jakelicata/SunTracker/Mechanical Description.pdf

## ESC Sun Tracker with One Actuator Motion Manual

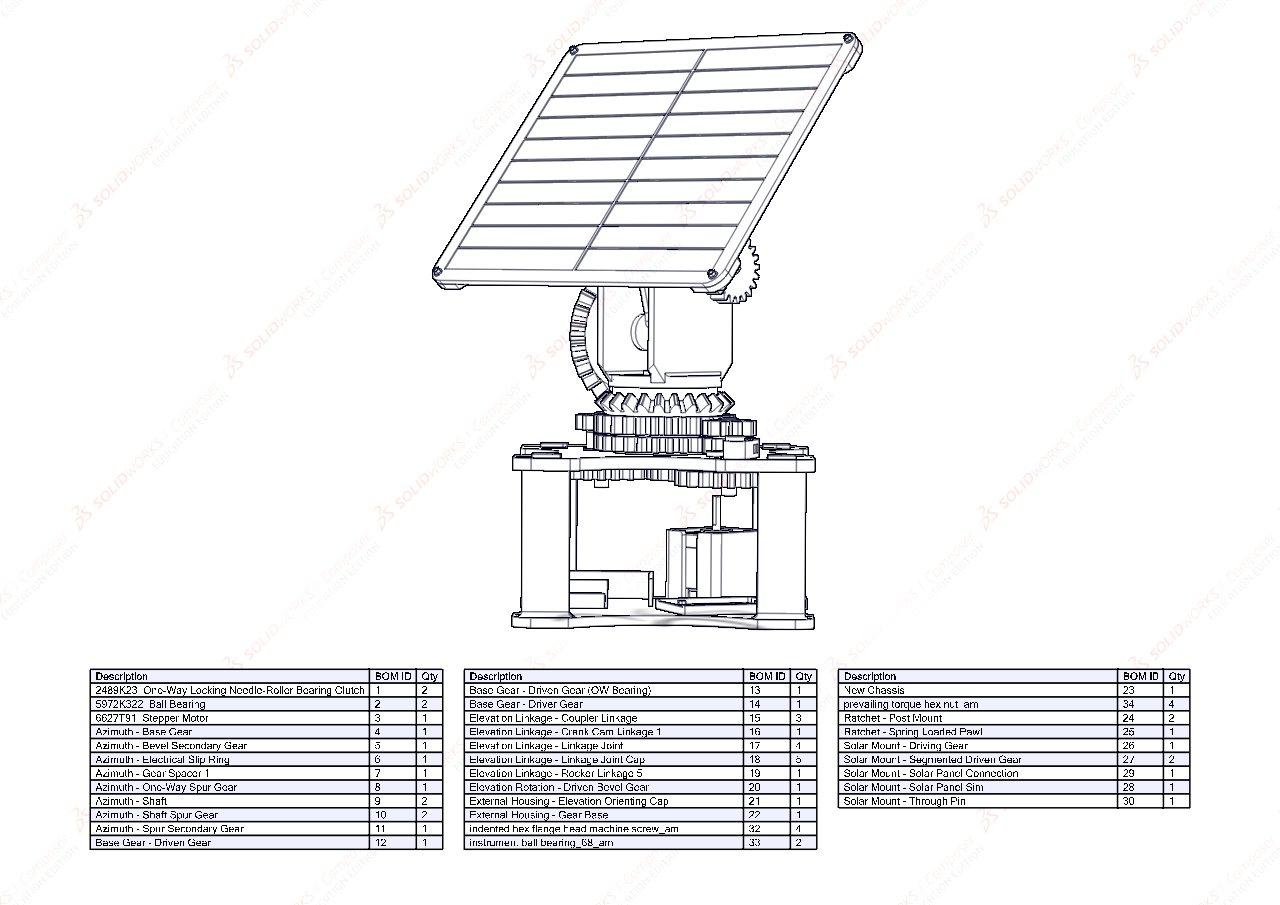
[picture p1: figure]

## PSU LF Capstone

Matthew Kuzmich | David Gogiberidze
Logan Ellenberger | Saje Behari
Jake Licata | Jeffery Su
Michael Day

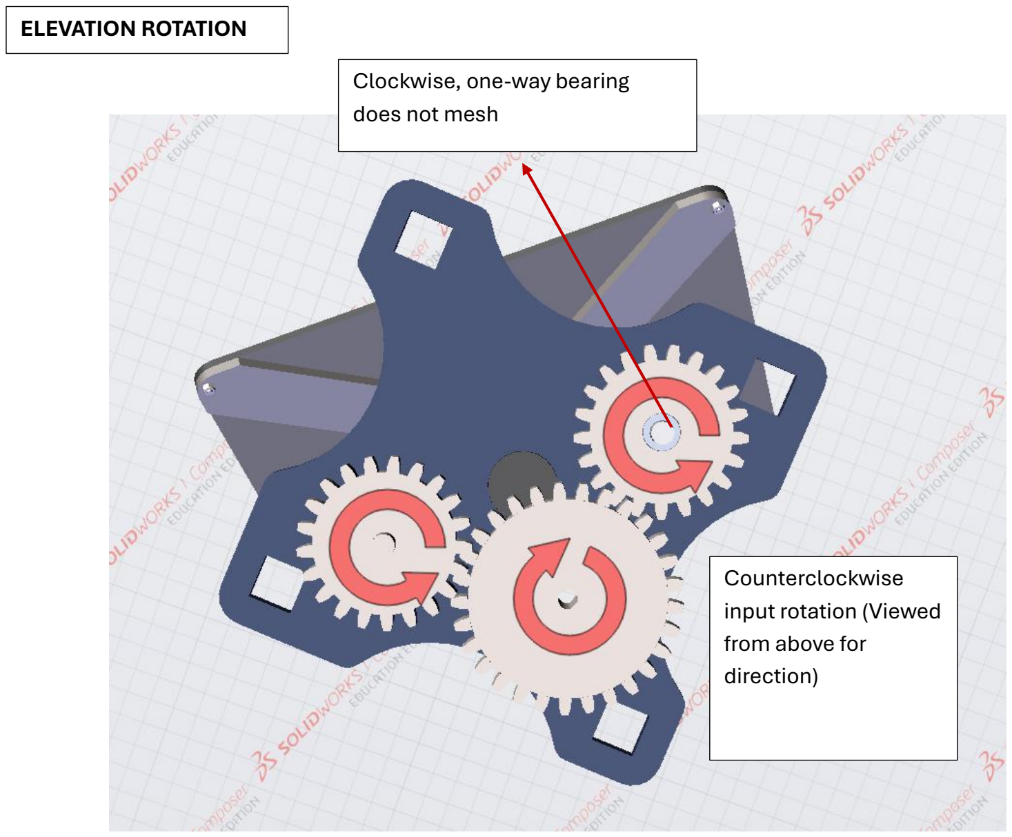
[picture p2: page 2]

Counterclockwise
input rotation (Viewed
from above for
direction)

Clockwise, one-way bearing does not mesh

ELEVATION ROTATION

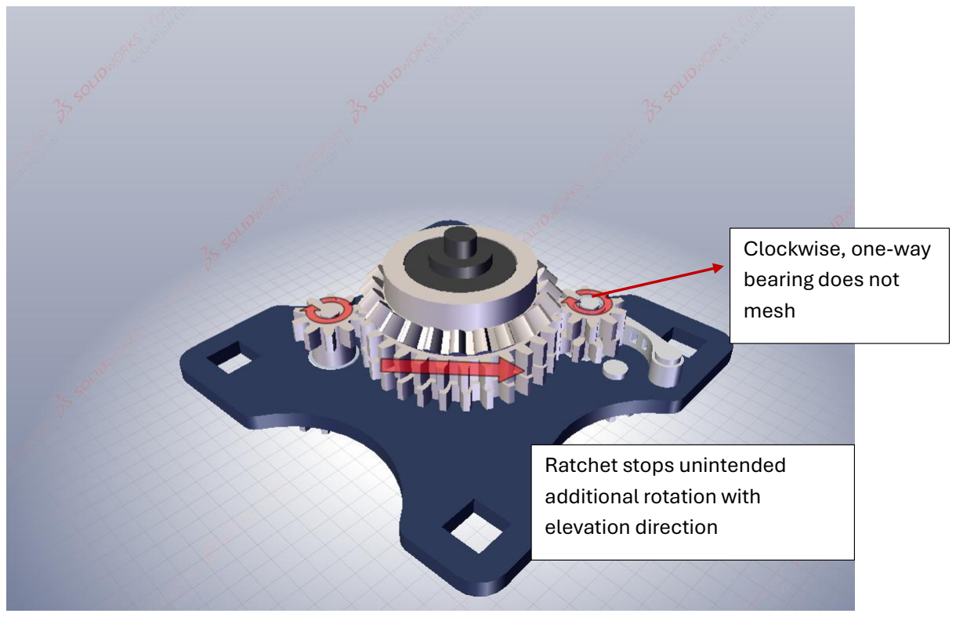
[picture p3: page 3]

Clockwise, one-way
bearing does not
mesh

Ratchet stops unintended
additional rotation with
elevation direction

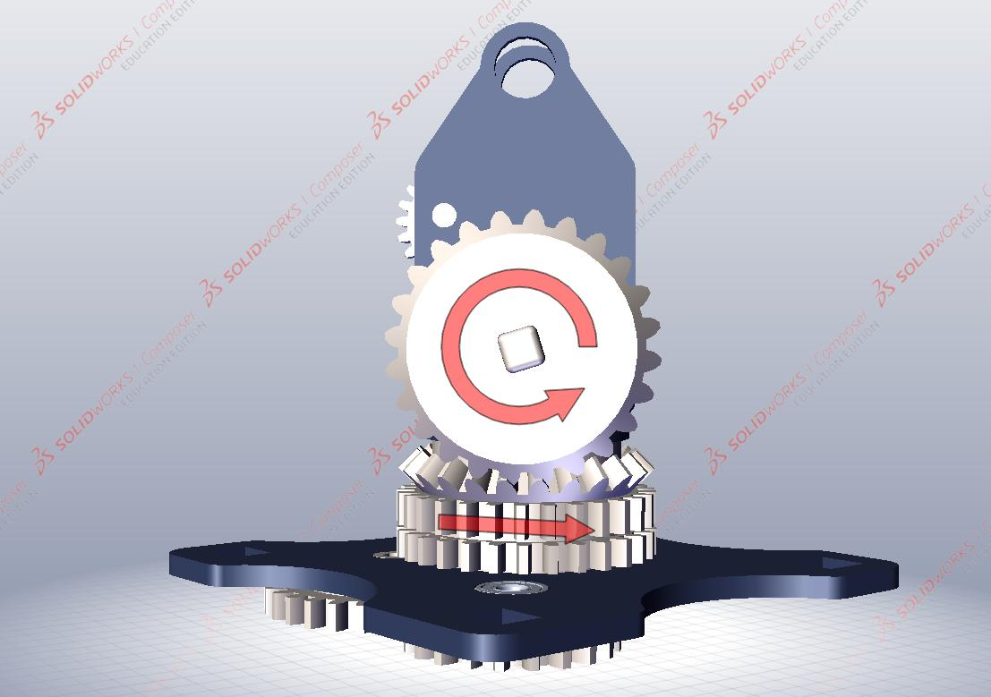
[picture p4: figure]
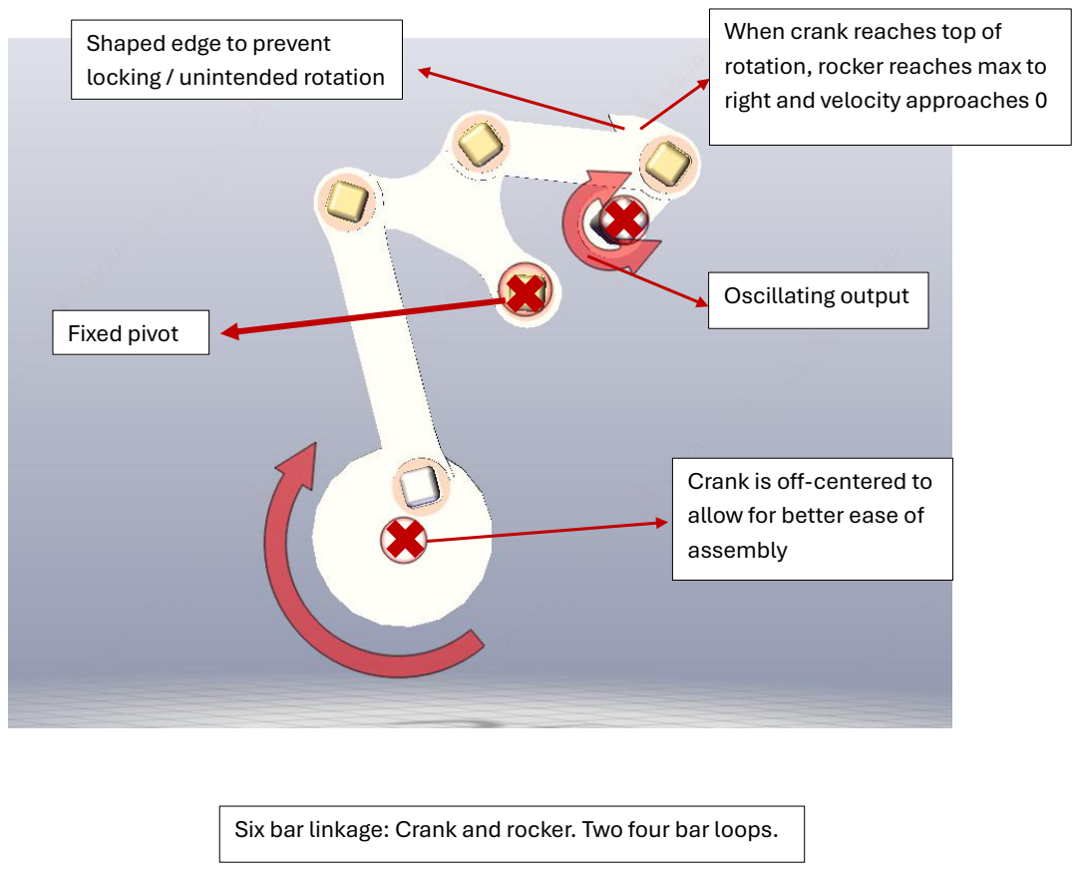
[picture p5: page 5]

Six bar linkage: Crank and rocker. Two four bar loops.

Crank is off-centered to
allow for better ease of
assembly

When crank reaches top of
rotation, rocker reaches max to right and velocity approaches 0

Shaped edge to prevent
locking / unintended rotation

Oscillating output
Fixed pivot

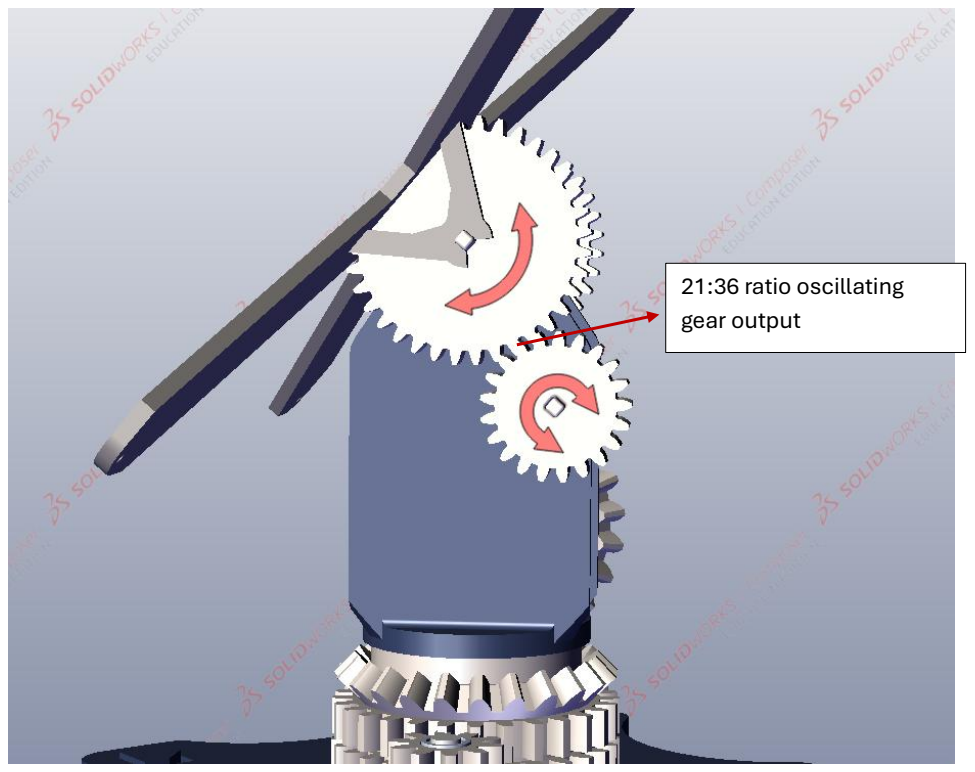
[picture p6: page 6]

21:36 ratio oscillating
gear output

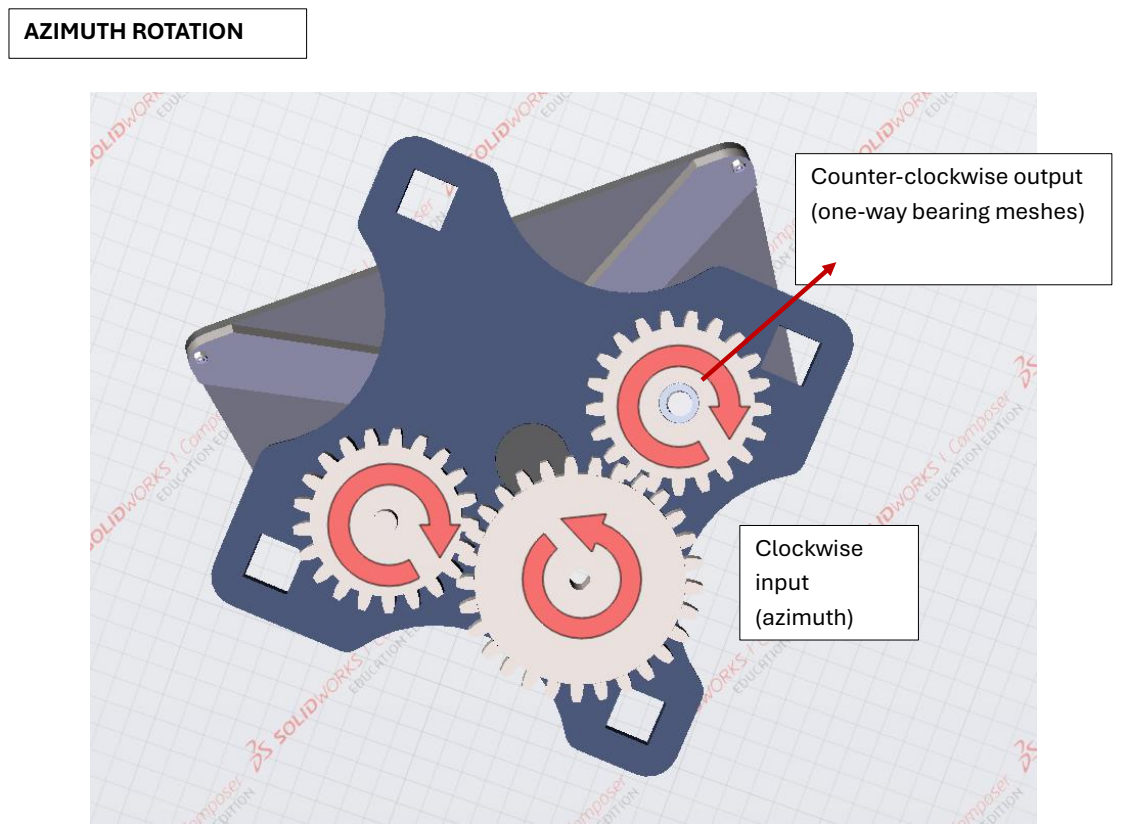
[picture p7: page 7]

Clockwise
input
(azimuth)

Counter-clockwise output
(one-way bearing meshes)

AZIMUTH ROTATION

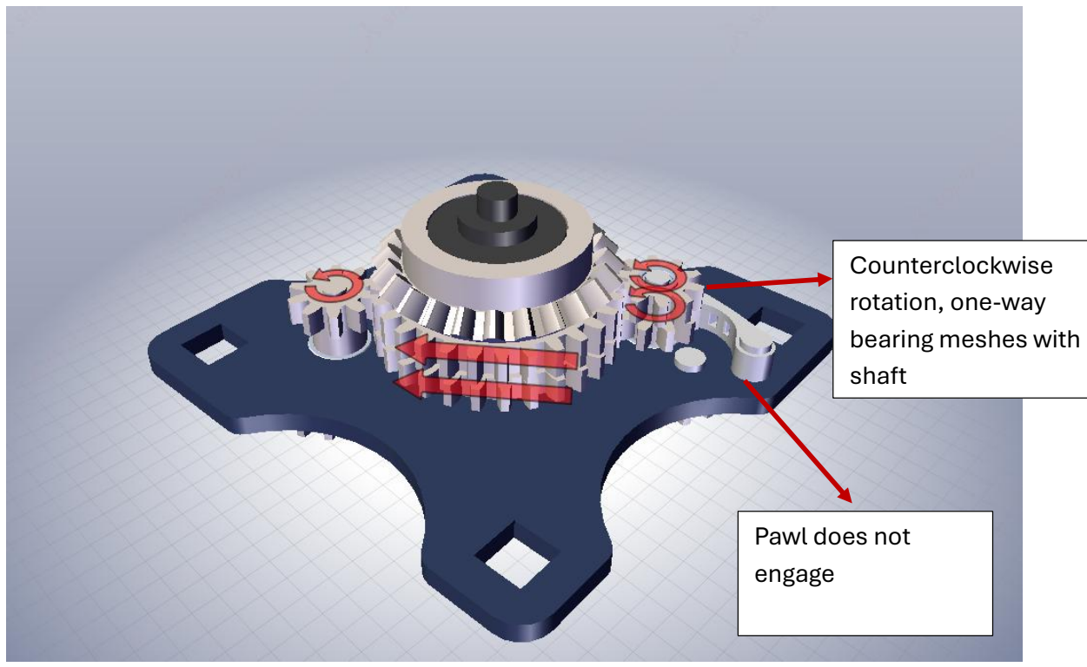
[picture p8: figure]
Counterclockwise rotation, one-way bearing meshes with shaft; Pawl does not engage
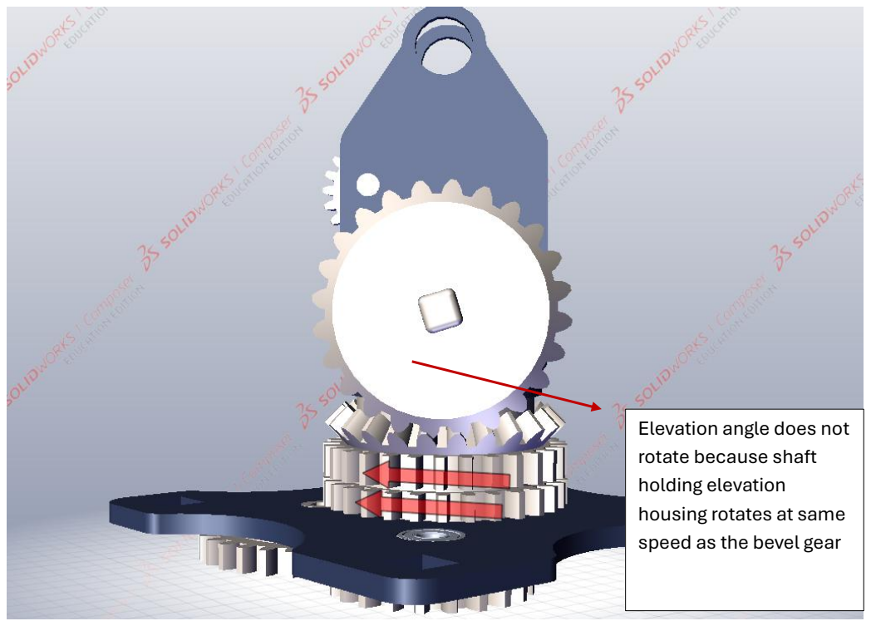
[picture p9: page 9]

Elevation angle does not
rotate because shaft
holding elevation
housing rotates at same
speed as the bevel gear

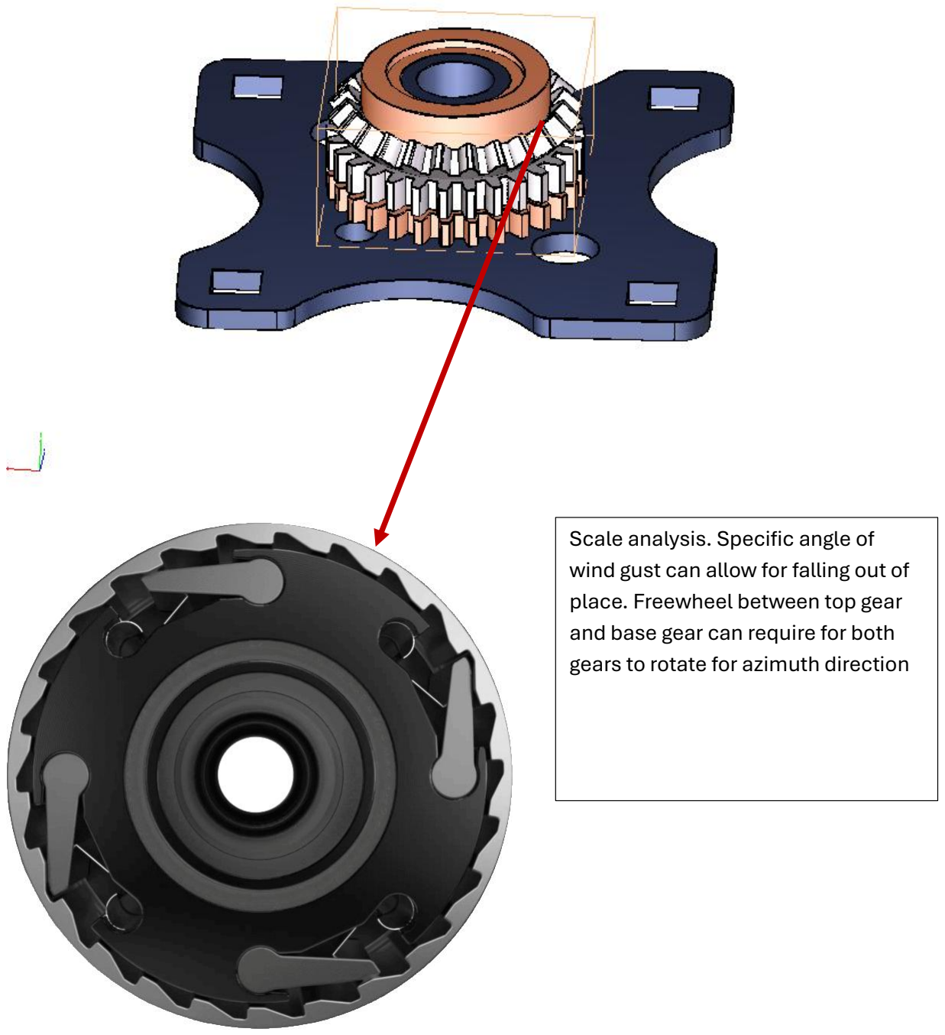
[picture p10: page 10]

Scale analysis. Specific angle of wind gust can allow for falling out of place. Freewheel between top gear and base gear can require for both gears to rotate for azimuth direction
