jakelicata/SunTracker/(commit log)

2025-03-31 Create Motor movement
2025-04-16 Rename davidIMUcode to david original IMU code
2025-04-16 Rename rtc_basic_timestamp_print to RTC Printing Time
2025-04-16 Rename RTC Printing Time to zRTC Printing Time
2025-04-16 Rename SunTrackingArduino to zArduino Sun Tracking No Motor Code
2025-04-16 Create zSimulation Mode Done (az and el throughout day)
2025-04-16 Update zSimulation Mode Done (az and el throughout day)
2025-04-21 Create Simulation_before_merge.ino
    1. Rotate fully cw, rotate fully ccw —— done
    2. Repeat (total of two cycles) —— done
    3. "day” command to execute and simulate realistic sun tracking —— not implemented
    4. (stretch) Serial monitor prompting - user inputs azimuth angle, user inputs elevation angle - system executes and goes to that angle —— not implemented
    5. (Optional and not accurate) rotate x degrees ccw/cw ---- done
2025-04-28 Rename Motor movement to Old_Prototyping_Code/MotorMovement
2025-04-28 Rename david original IMU code to Old_Prototyping_Code/IMUtesting
2025-04-28 Rename zRTC Printing Time to Old_Prototyping_Code/RTCPrintingTime
2025-04-28 Rename zArduino Sun Tracking No Motor Code to Old_Prototyping_Code/SunTrackingOverviewNoMotor
2025-04-28 Rename zSimulation Mode Done (az and el throughout day) to Simulation Mode Done (az and el throughout day)
2025-04-28 Rename Simulation Mode Done (az and el throughout day) to Old_Prototyping_Code/DailyAzAndElSimulationMode
2025-06-10 Rename ESC Sun Tracking Motion Description.pdf to Motion/Mechanical Description.pdf
2025-06-10 Rename ESC Sun Tracking Motion Description.pdf to Mechanical Description.pdf
